SDSURocketProject/Helix/README.md

# Helix

Coming Soon(TM)

(C) 2019

# Todo
* Build the Helix System.
