SDSURocketProject/Helix/Extention boards/Extention Boards.pdf

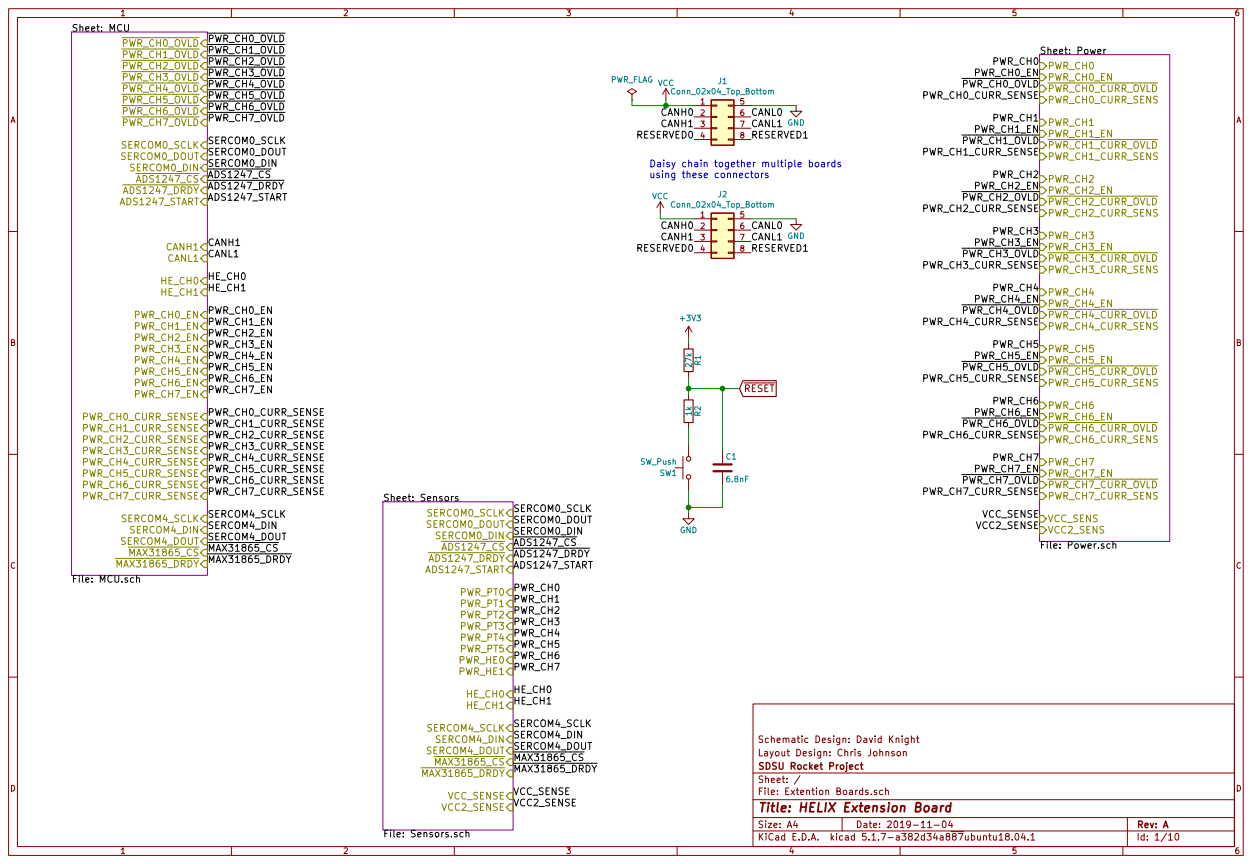
[picture p1: page 1]

Daisy chain together multiple boards
using these connectors

Schematic Design: David Knight
Layout Design: Chris Johnson
File: Extention Boards.sch Sheet: / SDSU Rocket Project

Id: 1/10 Title: HELIX Extension Board

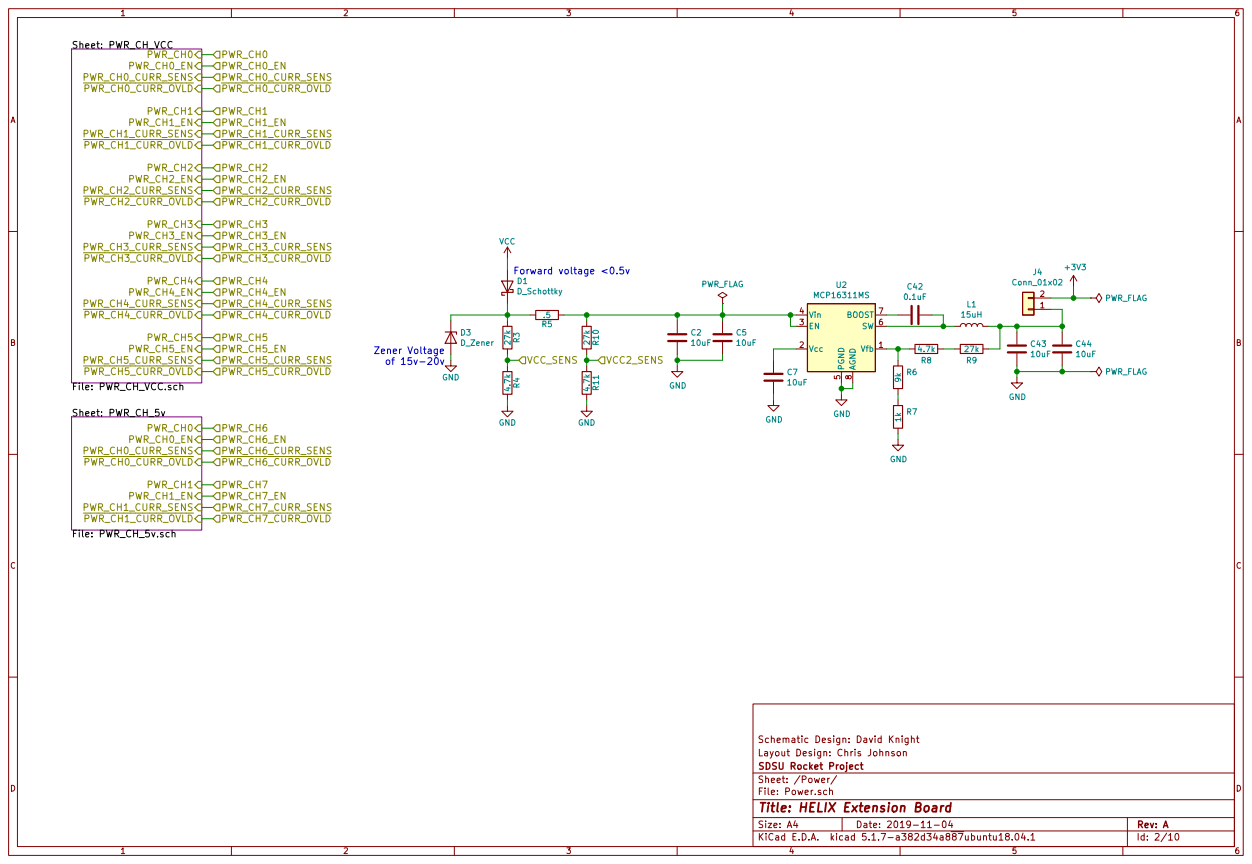
[picture p2: page 2]

Schematic Design: David Knight
Layout Design: Chris Johnson
File: Power.sch Sheet: /Power/ SDSU Rocket Project

Id: 2/10 Title: HELIX Extension Board

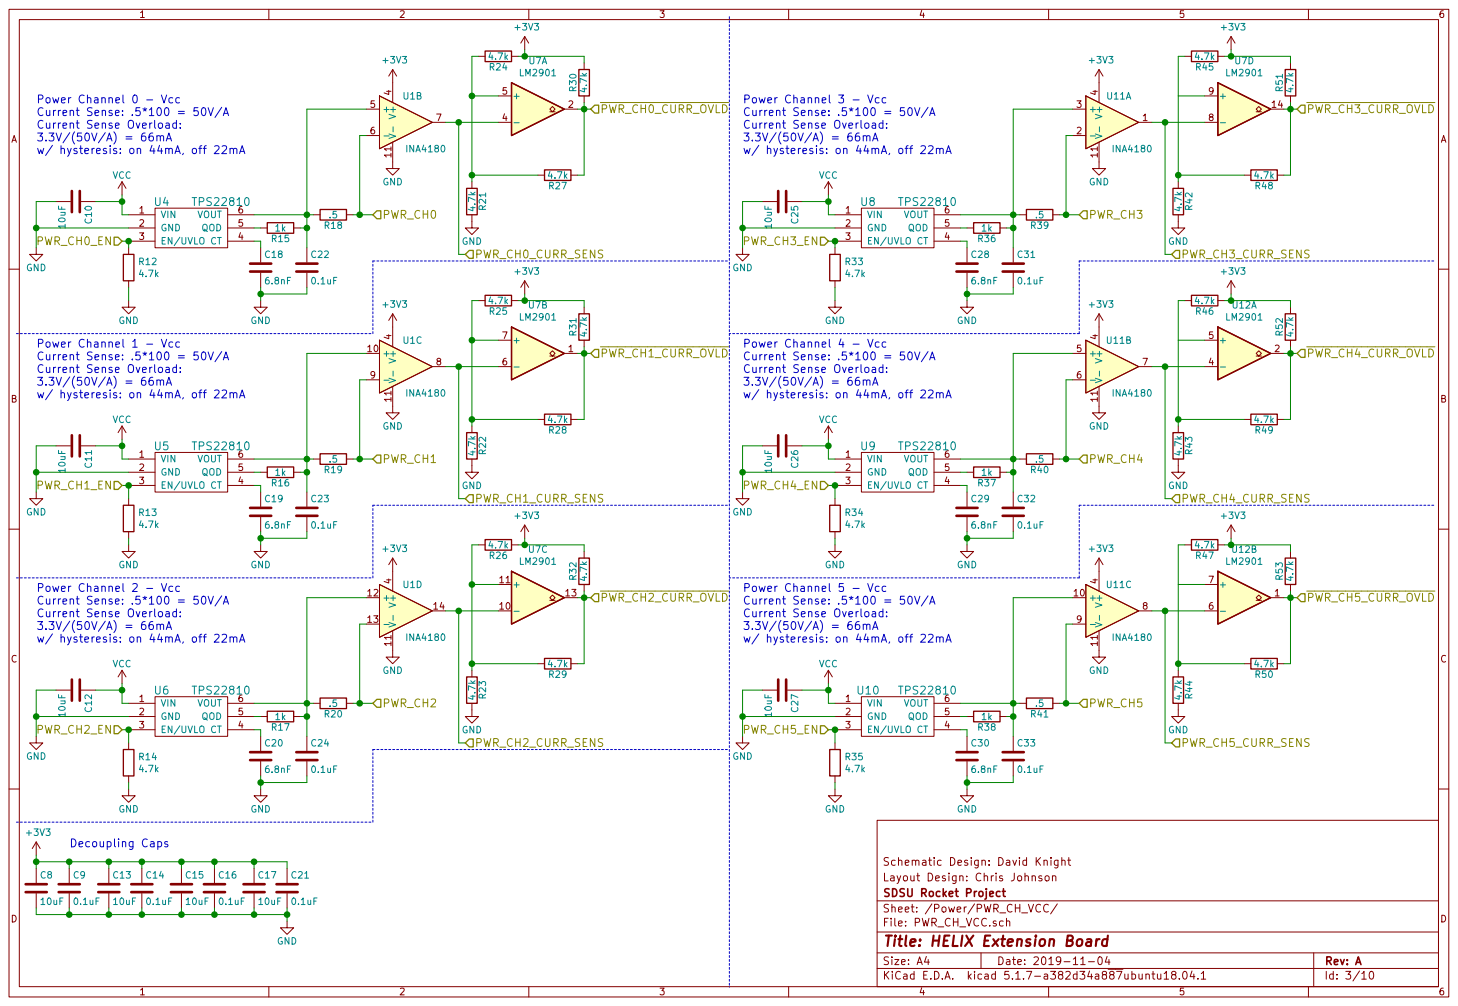
[picture p3: page 3]

Schematic Design: David Knight C16

Layout Design: Chris Johnson
SDSU Rocket Project
Sheet: /Power/PWR_CH_VCC/
File: PWR_CH_VCC.sch
Id: 3/10 Title: HELIX Extension Board

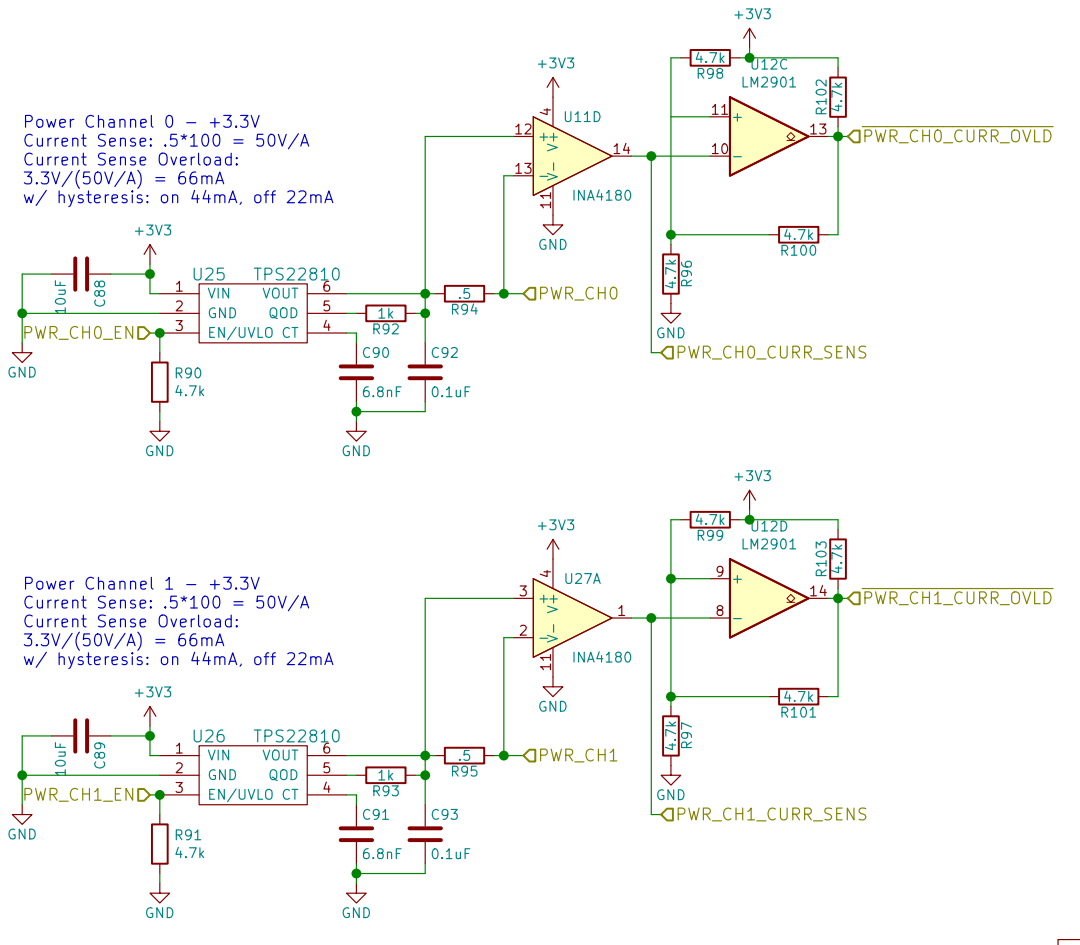
[picture p4: page 4]

Sheet: /Power/PWR_CH_5v/ GND GND

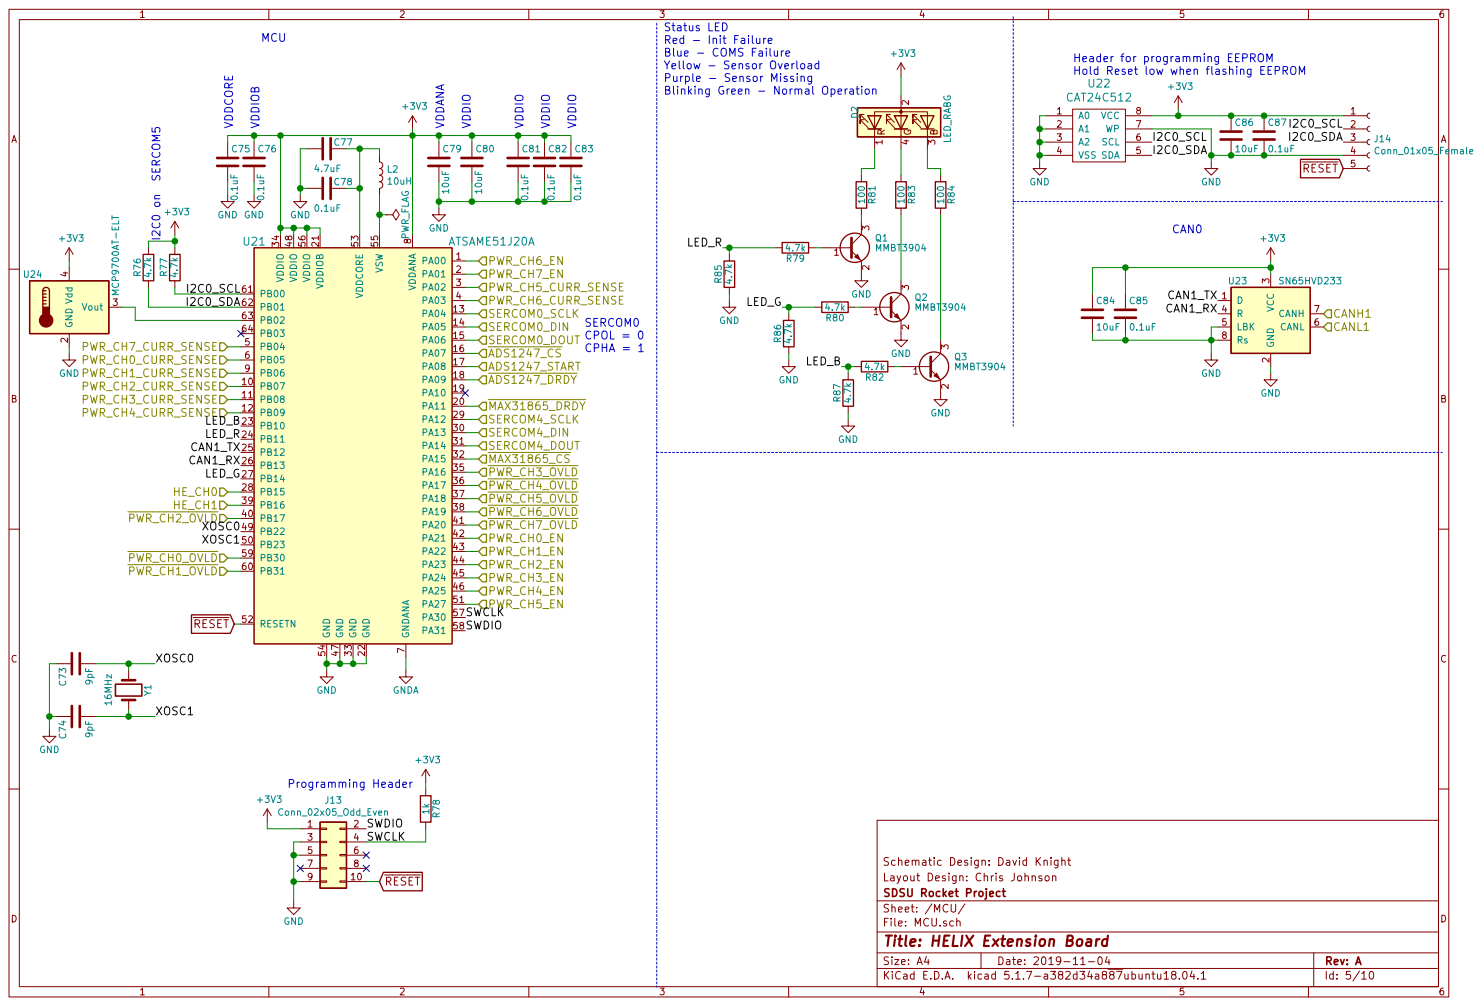
[picture p5: page 5]

Status LED
Red - Init Failure Blue - COMS Failure
C820.1uF GND

Yellow - Sensor Overload
Purple - Sensor Missing
Blinking Green - Normal Operation

Header for programming EEPROM
Hold Reset low when flashing EEPROM

Schematic Design: David Knight
Layout Design: Chris Johnson
File: MCU.sch Sheet: /MCU/ SDSU Rocket Project

Id: 5/10 Title: HELIX Extension Board

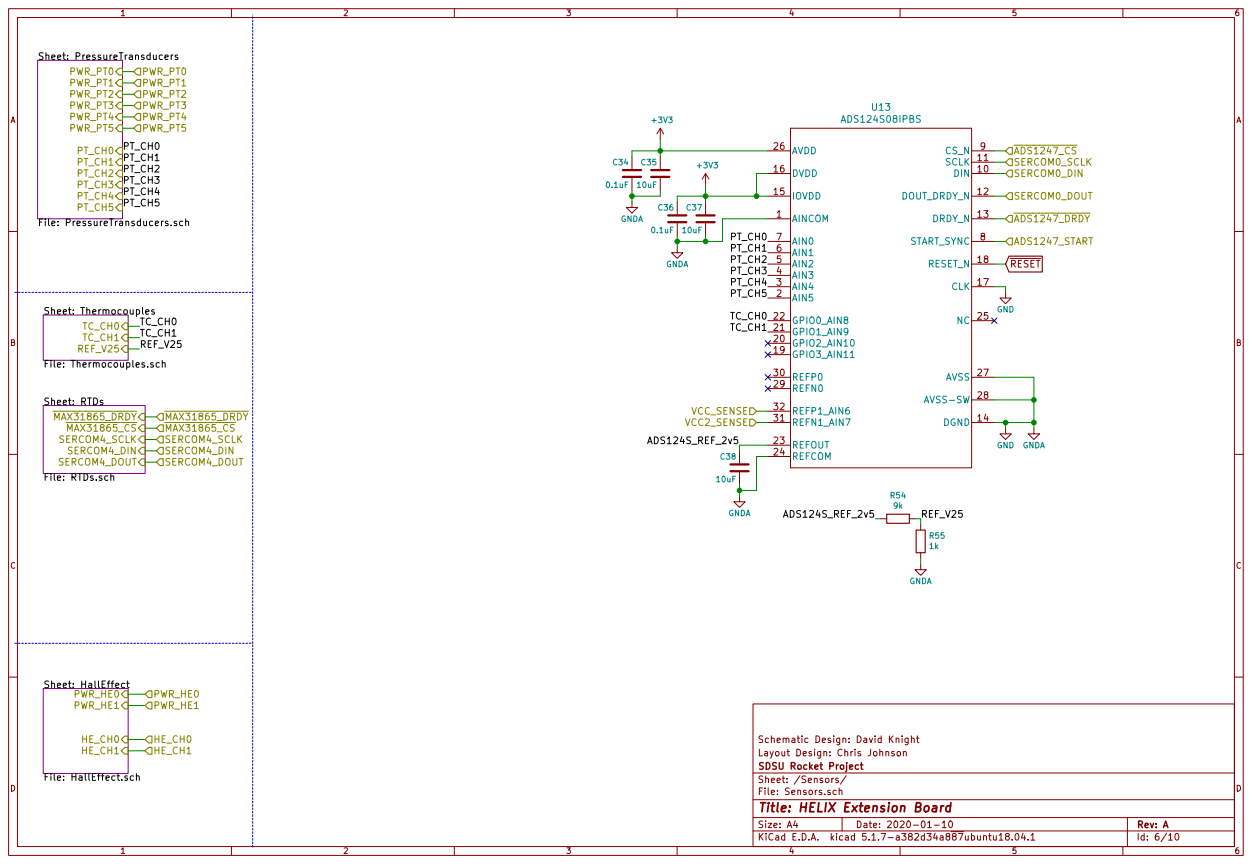
[picture p6: page 6]

Sheet: RTDs File: RTDs.sch MAX31865_CS
MAX31865_DRDY

Sheet: HallEffect File: HallEffect.sch HE_CH0
PWR_HE0

Schematic Design: David Knight
Layout Design: Chris Johnson
File: Sensors.sch Sheet: /Sensors/ SDSU Rocket Project

Id: 6/10 Title: HELIX Extension Board

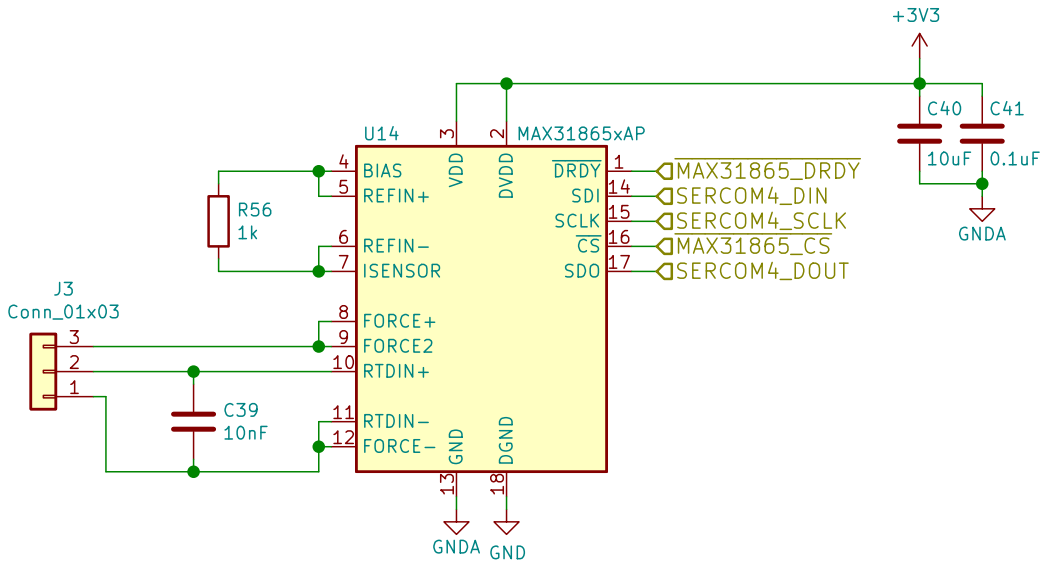
[picture p7: page 7]

Layout Design: Chris Johnson
File: RTDs.sch Sheet: /Sensors/RTDs/ SDSU Rocket Project

Id: 7/10 Title: HELIX Extension Board

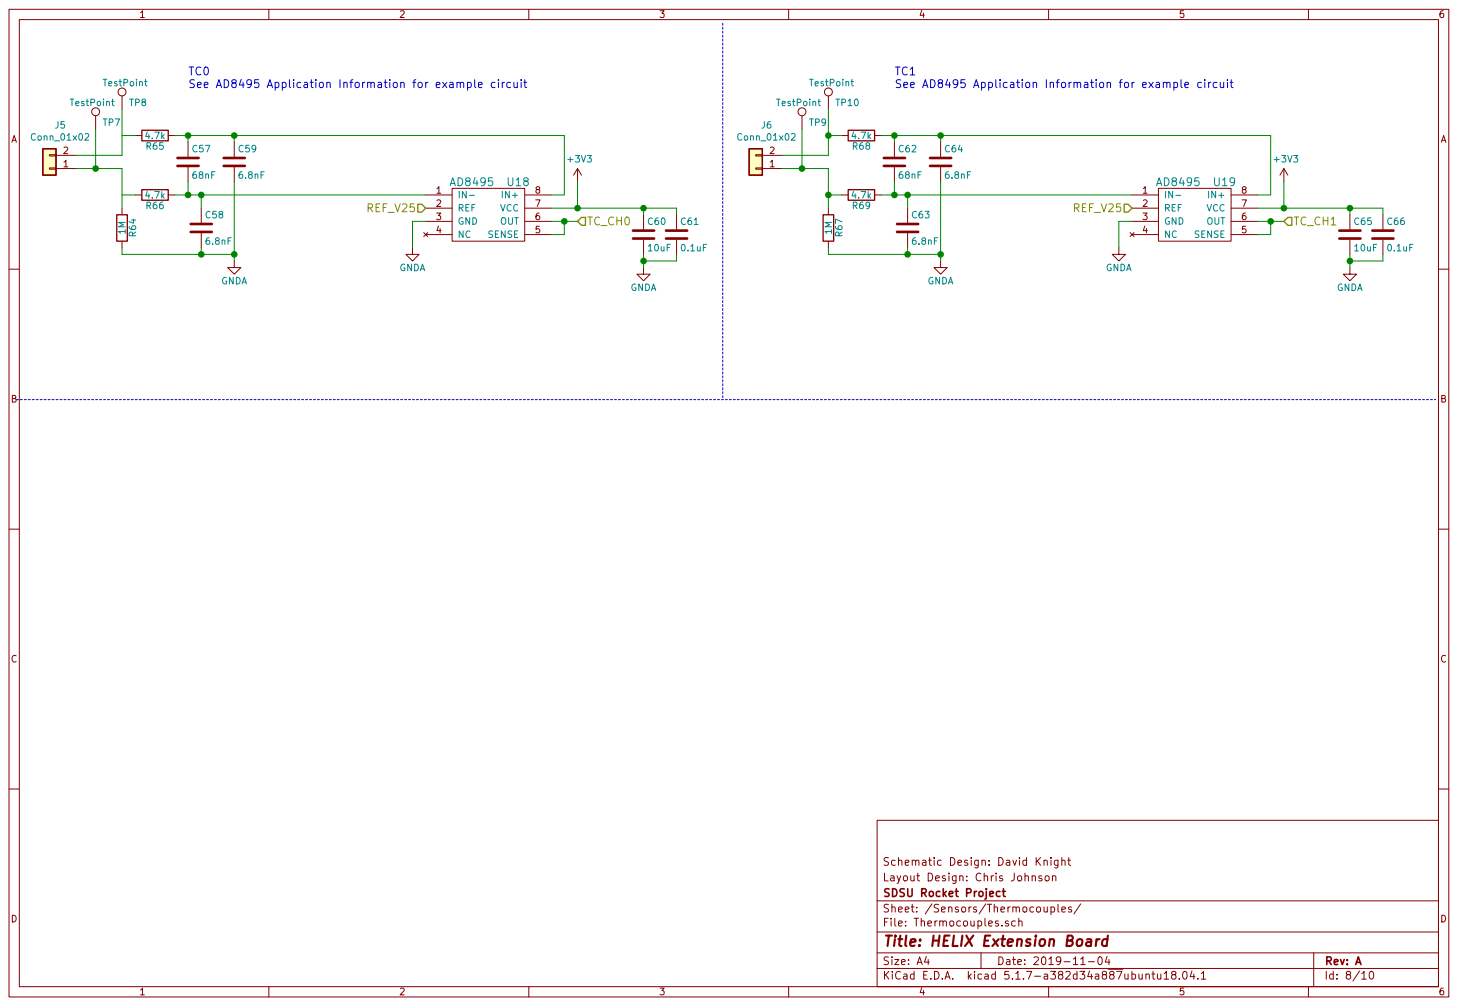
[picture p8: page 8]

See AD8495 Application Information for example circuit

Schematic Design: David Knight
Layout Design: Chris Johnson
SDSU Rocket Project
Sheet: /Sensors/Thermocouples/
File: Thermocouples.sch
Id: 8/10 Title: HELIX Extension Board

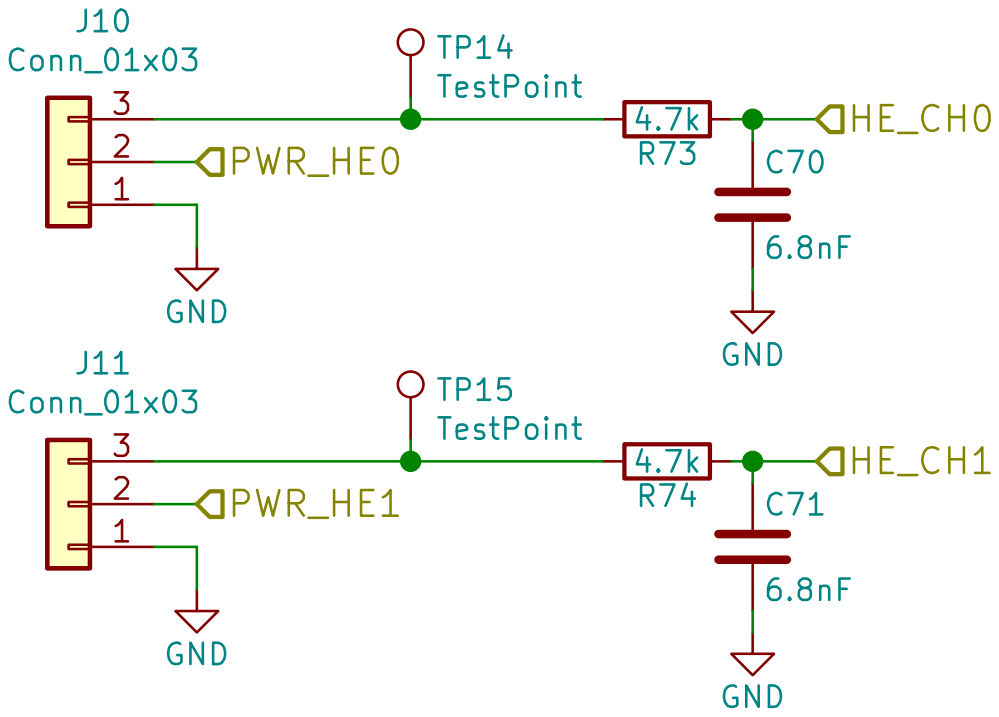
[picture p9: page 9]

Schematic Design: David Knight
Layout Design: Chris Johnson
File: HallEffect.sch Sheet: /Sensors/HallEffect/ SDSU Rocket Project

Id: 9/10 Title: HELIX Extension Board

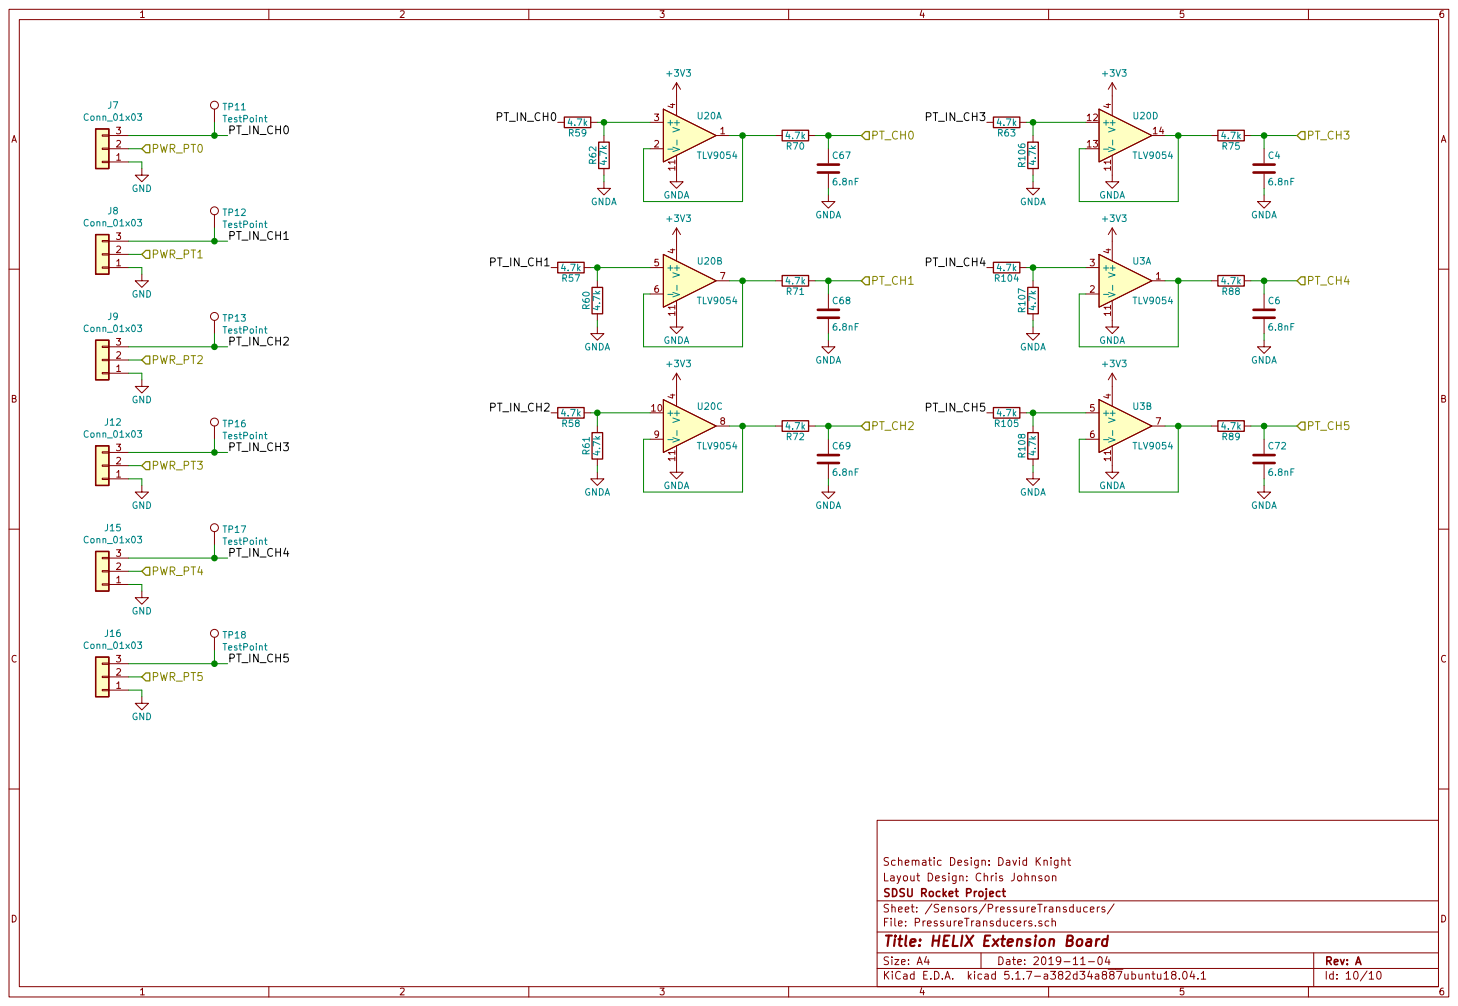
[picture p10: page 10]

Schematic Design: David Knight
Layout Design: Chris Johnson
File: PressureTransducers.sch Sheet: /Sensors/PressureTransducers/ SDSU Rocket Project

Id: 10/10 Title: HELIX Extension Board
