SDSURocketProject/Helix/(commit log)

2019-07-10 Created new Extention Boards project
    [Extention Boards.kicad_pcb, Extention Boards.sch]
2019-07-12 Added new components library
    [Extention Boards.sch]
2019-07-12 Created Power and MCU sections
    [Extention Boards.sch, MCU.sch, Memory.sch, Power.sch, Sensors.sch]
2019-07-12 Added some power out protection
    [Power.sch]
2019-07-12 Added now symbol for INA4180 and created power channels
    [Power.sch]
2019-07-12 Imported pins on root sheet
    [Extention Boards.sch]
2019-07-13 Added new labels on MCU page
    [MCU.sch, Memory.sch, Sensors.sch]
2019-07-14 Added a bunch of stuff
    [Extention Boards.sch, HallEffect.sch, MCU.sch, Memory.sch, PTs.sch, Power.sch, RTDs.sch, Sensors.sch]
2019-07-14 Re-annotated schematic
    [Extention Boards.sch, MCU.sch, Power.sch, RTDs.sch, Sensors.sch, Thermocouples.sch]
2019-07-14 Replaces 8x1 muxes and added some resistor values
    [Power.sch, RTDs.sch, Sensors.sch]
2019-07-15 Fixed ERC errors
    [Extention Boards.sch, MCU.sch, Power.sch, RTDs.sch, Sensors.sch, Thermocouples.sch]
2019-09-04 Made a lot of changes
    [Extention Boards.sch, HallEffect.sch, MCU.sch, PWR_CH.sch, Power.sch, PressureTransducers.sch, RTDs.sch, Sensors.sch]
2019-09-05 Updated schematic to kicad v5 and made minor cosmetic changes
    [Extention Boards-2019-09-04-18-13-05.sch, Extention Boards.sch, HallEffect-2019-09-04-18-13-05.sch, HallEffect.sch, MCU-2019-09-04-18-13-05.sch, MCU.sch, PWR_CH-2019-09-04-18-13-05.sch, PWR_CH.sch]
2019-09-19 Added SAMC21J18A to schematic and fixed previous DRC errors
    [Extention Boards.sch, HallEffect.sch, MCU.sch, PWR_CH.sch, Power.sch, PressureTransducers.sch, RTDs.sch, Sensors.sch]
2019-09-24 Changed symbol reference locations and removed ref voltage from AD8495
    [Extention Boards.sch, HallEffect.sch, MCU.sch, PWR_CH.sch, Power.sch, PressureTransducers.sch, RTDs.sch, Sensors.sch]
2019-09-24 Fixed some errors and replotted schematic
    [Extention Boards.sch, HallEffect.sch, MCU.sch, Power.sch, PressureTransducers.sch, RTDs.sch, Sensors.sch, Thermocouples.sch]
2019-09-27 Corrected location of helix lib
    [Extention Boards.sch, HallEffect.sch, MCU.sch, PressureTransducers.sch, Thermocouples.sch]
2019-09-27 Corrected bold nets and notes
    [Extention Boards.sch, HallEffect.sch, MCU.sch, PWR_CH.sch, Power.sch, PressureTransducers.sch, RTDs.sch, Sensors.sch]
2019-10-02 removed TVS diodes, changed reset capacitor to 3.3nF, changed pull-up resistor on SWCLK to 2.7k, changed capacitor on REFOUT of ADS1247 to 10uF
2019-10-15 made many small changes to schematic, in need of cleanup
    [Extention Boards.sch, HallEffect.sch, MCU.sch, PWR_CH.sch, Power.sch, PressureTransducers.sch, RTDs.sch, Sensors.sch]
2019-10-15 Updated .bak files
    [Extention Boards.sch, HallEffect.sch, MCU.sch, PWR_CH.sch, Power.sch, PressureTransducers.sch, RTDs.sch, Sensors.sch]
2019-10-15 Changed Extention boads from 5v to 3.3v and changed uC from SAMC21 to SAME51
    [Extention Boards.sch, HallEffect.sch, MCU.sch, PWR_CH.sch, Power.sch, PressureTransducers.sch, RTDs.sch, Sensors.sch]
2019-10-28 initial commit of power distro board
    [Distro Board.kicad_pcb, Distro Board.sch, MCU.sch, powerDistro.sch]
2019-11-04 Removed TVS diodes and added test points
    [Extention Boards.sch, HallEffect.sch, MCU.sch, PWR_CH.sch, Power.sch, PressureTransducers.sch, RTDs.sch, Sensors.sch]
2019-11-04 Corrected bold text on mcu schematic page
    [MCU.sch]
2019-11-05 Modified PT inputs to divide down to 2.5v to be compatible with 3.3v supply
    [Extention Boards.sch, HallEffect.sch, MCU.sch, PWR_CH.sch, Power.sch, PressureTransducers.sch, RTDs.sch, Sensors.sch]
2019-11-05 Corrected minor mitakes in helix symbol library and schematic
    [Extention Boards.sch, HallEffect.sch, MCU.sch, PWR_CH.sch, Power.sch, PressureTransducers.sch, RTDs.sch, Sensors.sch]
2019-11-10 Corrected bold text bug
    [Extention Boards.sch, HallEffect.sch, MCU.sch, PWR_CH.sch, Power.sch, PressureTransducers.sch, RTDs.sch, Sensors.sch]
2019-11-11 Corrected issues with MC33063 schematic
    [HallEffect.sch, MCU.sch, PWR_CH.sch, Power.sch, PressureTransducers.sch, RTDs.sch, Sensors.sch, Thermocouples.sch]
2020-01-10 Added missing 3v3 supply for decoupling caps on SN74LV4052
    [Extention Boards.sch, HallEffect.sch, MCU.sch, PWR_CH.sch, Power.sch, PressureTransducers.sch, RTDs.sch, Sensors.sch]
2020-01-11 Replaced the CAT24C256 with the CAT24C512
    The two components are exactly the same in package and usage, the
    only difference is that the CAT24C512 has twice as much memory. The
    cost difference is small so the extra memory size is worth it.
    [Extention Boards.sch, HallEffect.sch, MCU.sch, PWR_CH.sch, Power.sch, PressureTransducers.sch, RTDs.sch, Sensors.sch]
2020-01-11 Fixed component annotations to not include page number
    [Extention Boards.sch, HallEffect.sch, MCU.sch, PWR_CH.sch, Power.sch, PressureTransducers.sch, RTDs.sch, Sensors.sch]
2020-01-11 Added footprints to components
    The resistor array for the PT inputs on the sensor section was changed
    from a network of 8 resistors to 3 networks of 2 resistors. This is
    cheaper to purchase, there are more products available, and
    accomplishes the same problem as the network of 8.
    [Extention Boards.sch, HallEffect.sch, MCU.sch, PWR_CH.sch, Power.sch, PressureTransducers.sch, RTDs.sch, Sensors.sch]
2020-02-22 Fixed power issue on SAME51J20A
    The VDDCORE pin is actually a voltage output of ~1.2v that is
    intended to supply power to the VSW pin when in Switching mode.
    The SAME51J20A symbol was fixed in the helix symbol library to
    indicate the VDDCORE pin as a voltage output rather than an input
    and the schematic was also changed to reflect the recommended
    power supply setup from the SAME5x datasheet.
    [MCU.sch]
2020-02-22 Corrected a mistake on the PWR_CHx_OVLD circuits
    The proper design for a comparator with hysteresis has pull-up
    resistors on the output of the comparator. The current trip
    calculations for the POWER_CHx_OVLD outputs have also been updated
    to reflect the addition of hysteresis that was added awhile ago.
    [HallEffect.sch, MCU.sch, PWR_CH.sch, PressureTransducers.sch, RTDs.sch, Thermocouples.sch]
2020-09-27 Fixed mistakes that were found on uC_ProtoBoard_v2
    [MCU.sch]
2020-09-27 Added temperature sensor
    [MCU.sch]
2020-09-27 Removed MCP3008 to save board space and cost
    The VCC and current sense measurements have been moved use
    the ADCs on the microcontroller.
    [Extention Boards.sch, HallEffect.sch, MCU.sch, PWR_CH.sch, Power.sch, PressureTransducers.sch, RTDs.sch, Sensors.sch]
2020-09-27 Added 3 additional PTs and removed one HE
    This is to meet SEB requirements for the engine
    [Extention Boards.sch, HallEffect.sch, MCU.sch, PWR_CH_5v.sch, PWR_CH_VCC.sch, Power.sch, PressureTransducers.sch, RTDs.sch]
2020-09-27 Added ADS124S08 and MAX31865
    [Extention Boards.sch, MCU.sch, Power.sch, RTDs.sch, Sensors.sch, Thermocouples.sch]
2020-10-05 Moved to new ADC and RTD IC
    [Extention Boards.sch, MCU.sch, PWR_CH_5v.sch, PWR_CH_VCC.sch, PressureTransducers.sch, Thermocouples.sch]
2020-10-10 New voltage reg, better voltage protection, and consolidated component counts
    [Extention Boards.sch, MCU.sch, PWR_CH_5v.sch, PWR_CH_VCC.sch, Power.sch, PressureTransducers.sch, RTDs.sch, Sensors.sch]
